DivyamSaini05/Project-Aeros/AEROS_Electronics_Schematic (1).pdf

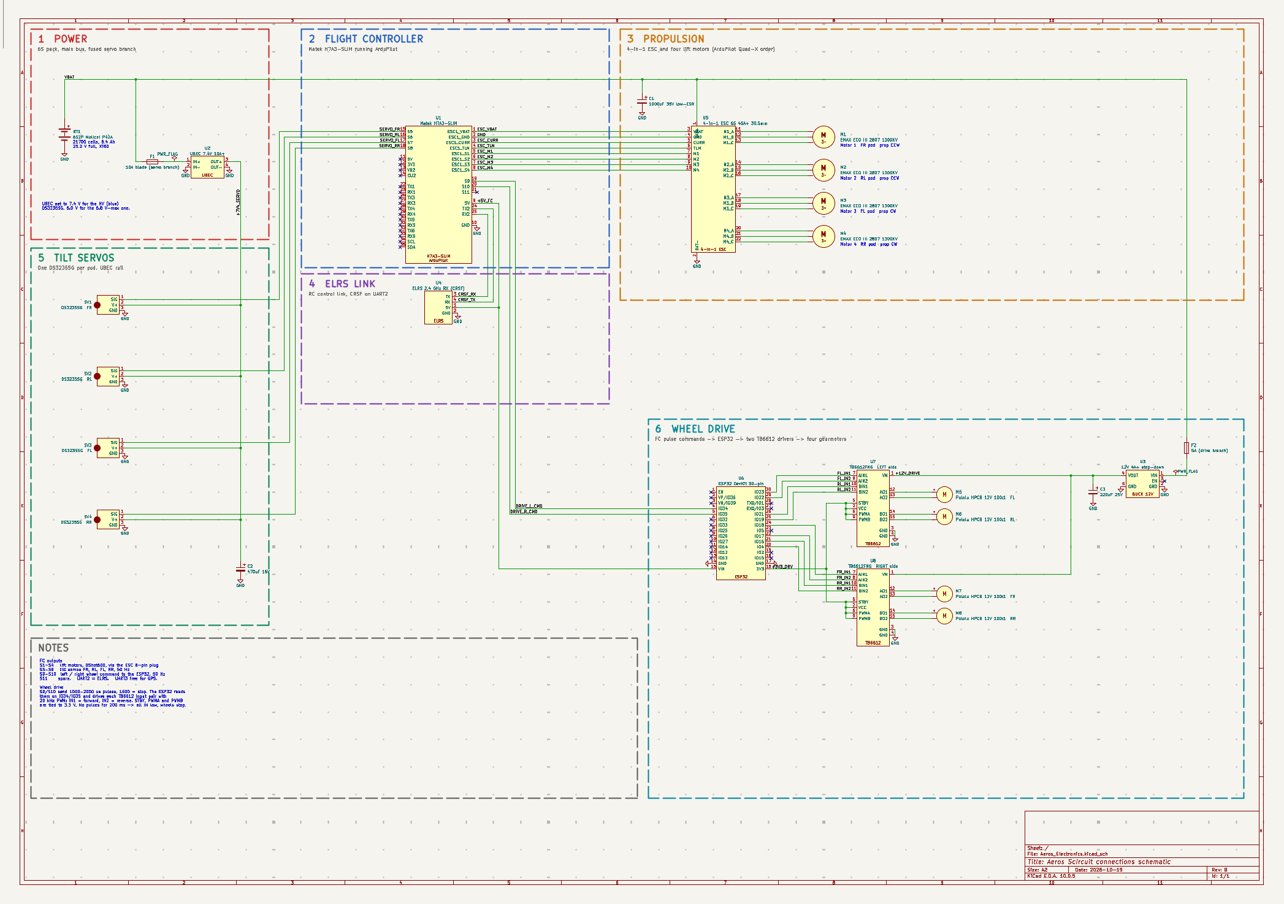
[picture p10: page 1]
