DivyamSaini05/Project-Aeros/AEROS_7in_BOM1_div.xlsx

# | Subsystem | Component | Spec / Part | Qty | Unit Price (USD) | Line Total (USD)
Flight Control & Propulsion
1 | Flight Control & Propulsion | Flight controller | Matek H7A3-SLIM, ArduPilot, 11 PWM out, CAN | 1 | $79.00 | $79.00 | Product page (https://www.nextfpv.com/products/matek-flight-controller-h7a3-slim)
2 | Flight Control & Propulsion | 4-in-1 ESC | SpeedyBee 55A 3-6S OX32 (AM32-based), 30.5x30.5 | 1 | $79.99 | $79.99 | Product page (https://www.getfpv.com/speedybee-55a-3-6s-ox32-4-in-1-esc-30-5x30-5.html)
3 | Flight Control & Propulsion | Lift motors | EMAX ECO III (E3) 2807 1300KV, 6S, 7in props | 5 | $23.99 | $119.95 | Product page (pick 1300KV) (https://www.racedayquads.com/products/emax-e3-series-2807-motor-1300kv-1500kv-1700kv)
4 | Flight Control & Propulsion | Propellers | 7in tri-blade (HQProp 7x4x3 or Gemfan 7040), 2CW+2CCW per set | 5 | $6.00 | $30.00 | Product page (https://www.racedayquads.com/products/hq-durable-7x4x3-tri-blade-7-prop-4-pack)
6 | Flight Control & Propulsion | ELRS receiver | RadioMaster RP3 V2 2.4GHz diversity | 1 | $22.00 | $22.00 | Product page (https://www.buddyrc.com/collections/receiver/products/radiomaster-rp3-expresslrs-2-4ghz-nano-receiver)
7 | Flight Control & Propulsion | Transmitter | RadioMaster Pocket | 1 | $80.00 | $80.00 | https://motionrc.com/products/radiomaster-pocket-16-channel-elrs-transmitter-charcoal-hp0157-0054-m2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
Tilt & Ground Drive
8 | Tilt & Ground Drive | Tilt servos | DSServo DS3235SG 35 kg-cm, steel gear, waterproof | 5 | $28.00 | $140.00 | Amazon search (https://www.amazon.com/s?k=DSServo+DS3235SG+35kg+servo)
9 | Tilt & Ground Drive | Servo BEC | Matek UBEC DUO, 2 x 4A, 5-8V adjustable, 9-55V in | 2 | $16.00 | $32.00 | Product page (https://www.myfpvstore.com/9l3r)
10 | Tilt & Ground Drive | Drive gearmotors | Pololu micro metal gearmotor 250:1 HPCB 12V, extended shaft | 4 | $27.00 | $108.00 | Product page (https://www.pololu.com/product/3055)
12 | Tilt & Ground Drive | Drive controller | ESP32-DevKitC (Espressif) | 1 | $10.00 | $10.00 | Product page (https://www.digikey.com/en/products/detail/espressif-systems/ESP32-DEVKITC-32E/12091810)
13 | Tilt & Ground Drive | Motor drivers | Pololu TB6612FNG dual motor driver carrier | 2 | $6.00 | $12.00 | Product page (https://www.pololu.com/product/713)
14 | Tilt & Ground Drive | 12V regulator | Pololu D36V28F12 (or equivalent) step-down, 6S in to 12V | 1 | $18.00 | $18.00 | Product page (https://www.pololu.com/product/3786)
15 | Tilt & Ground Drive | Bearings | Flanged ball bearings (tilt axles + wheel hubs), 20 pack | 1 | $15.00 | $15.00 | Amazon search (match your CAD sizes) (https://www.amazon.com/s?k=flanged+ball+bearing+assortment)
Power
17 | Battery |  | 6S 21700 Li-ion 5000Mah battery pack | 2 | $100.00 | $200.00 | https://www.getfpv.com/lumenier-nav-5000mah-6s-21700-lithium-ion-battery-xt60.html?afid=aVlOV0hBdmd6THc9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
19 | Power | Wiring & connectors | XT60/XT30, 12/14/18/22 AWG silicone wire, JST-GH/SH leads, heat shrink | 1 | $40.00 | $40.00 | Amazon search (https://www.amazon.com/s?k=XT60+connectors+silicone+wire+kit)
20 | Power | Smoke stopper | XT60 smoke stopper for first power-up | 1 | $15.00 | $15.00 | GetFPV search (https://www.getfpv.com/catalogsearch/result/?q=smoke+stopper+xt60)
21 | Power | Charger | 6S balance charger with built-in AC (ToolkitRC M6AC class) | 1 | $65.00 | $65.00 | Product page (https://www.getfpv.com/toolkitrc-m6ac-300w-15a-1-6s-ac-charger-xt60.html)
22 | Power | Battery safety bag | LiPo/Li-ion fireproof bag | 1 | $15.00 | $15.00 | Amazon search (https://www.amazon.com/s?k=lipo+safe+bag)
3D Printing & Hardware
24 | 3D Printing & Hardware | CF filament | PLA-CF filament 1kg | 3 | $20.00 | $60.00 | https://www.amazon.com/Creality-Filament-Hyper-PLA-CF-Dimensional/dp/B0CP7SFQG9?sp_csd=d2lkZ2V0TmFtZT1zcF9hdGY
26 | 3D Printing & Hardware | Screw assortment | Stainless M2 / M2.5 / M3 hex, nylock nuts | 1 | $25.00 | $25.00 | Amazon search (https://www.amazon.com/s?k=M2+M2.5+M3+stainless+hex+socket+screw+assortment)
27 | 3D Printing & Hardware | Heat-set inserts | Brass M2.5 / M3 insert kit | 1 | $15.00 | $15.00 | Amazon search (https://www.amazon.com/s?k=brass+heat+set+inserts+M3+M2.5+kit)
28 | 3D Printing & Hardware | Consumables | Threadlocker, zip ties, battery straps, double-sided foam | 1 | $20.00 | $20.00 | Amazon search (https://www.amazon.com/s?k=blue+threadlocker+zip+ties+battery+strap)
 | Tools | Soldering Station | 100W Soldering iron, solder, flux | 1 | $60.00 | 60
 | Tools | Multimeter | Multimeter | 1 | 10 | $10.00
 | Toolls | Wire cutters | Wire stripper, cutters | 1 | $30.00 | $30.00
 | Tools | Wires | Variety pack | 1 | $30.00 | $30.00
 | Tools | Heat shrink tubes | Variety pack | 1 | $10.00 | $10.00
 |  |  |  |  | Parts subtotal | $1340.94
