DivyamSaini05/Project-Aeros/Aeros_Build-1_CFD.step

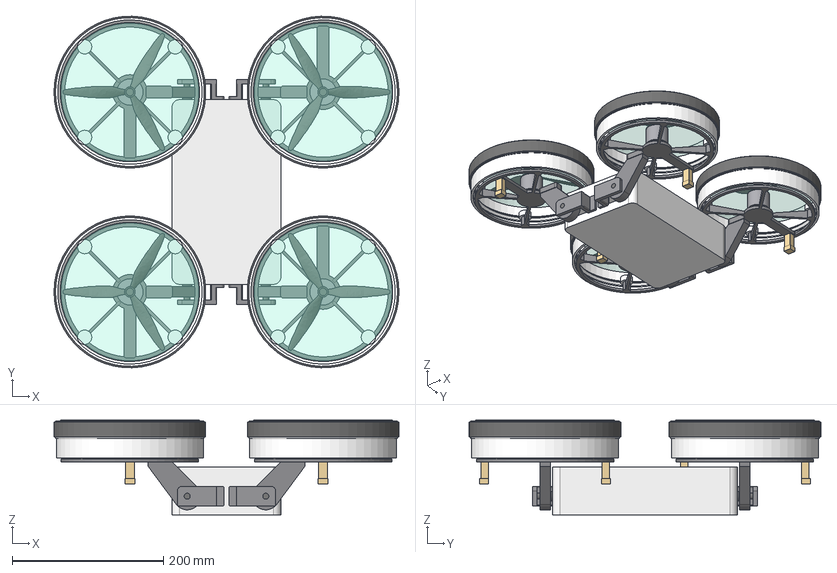
[picture p11: CAD file, 2026-10-21]
Aeros_Build-1_CFD.step
455.8 x 464.5 x 125.1 mm
Servo_FR
Yoke_FR
Servo_RL
Yoke_RL
Servo_FL
Yoke_FL
Servo_RR
Yoke_RR
Arm_FR
Horn_FR
Axle_FR
PodFrame_FR
Rollers_FR
RingDuct_FR
Tyre_FR
Motor_FR
Gearmotor_FR
Prop_FR_CCW
Arm_RL
Horn_RL
Axle_RL
PodFrame_RL
Rollers_RL
RingDuct_RL
Tyre_RL
Motor_RL
Gearmotor_RL
Prop_RL_CCW
Arm_FL
Horn_FL
Axle_FL
PodFrame_FL
Rollers_FL
RingDuct_FL
Tyre_FL
Motor_FL
Gearmotor_FL
Prop_FL_CW
Arm_RR
Horn_RR
Axle_RR
PodFrame_RR
Rollers_RR
RingDuct_RR
Tyre_RR
Motor_RR
Gearmotor_RR
Prop_RR_CW
RotorZone_FR
RotorZone_RL
RotorZone_FL
RotorZone_RR
