DivyamSaini05/Project-Aeros/Aeros_Build-1_PRINT.step

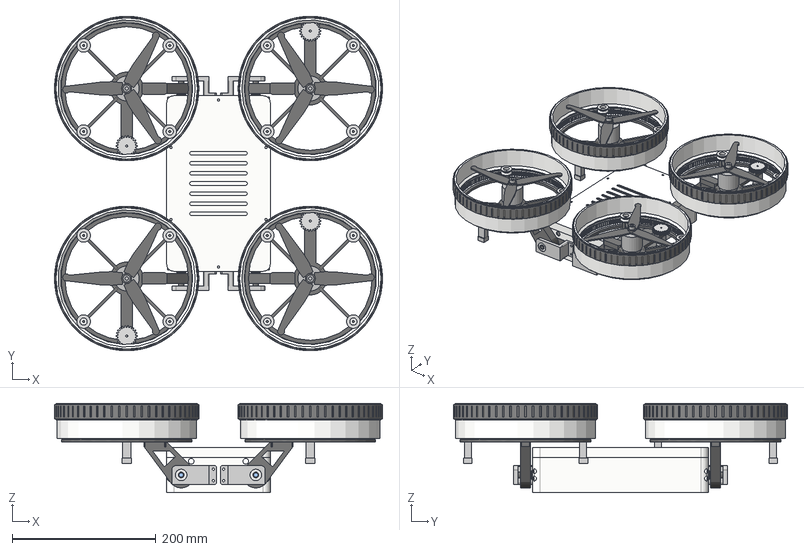
[picture p12: CAD file, 2026-10-21]
Aeros_Build-1_PRINT.step
455.8 x 464.6 x 124.1 mm
Ring wheel x 4
Tyre x 4
Pinion x 4
Motor stator 2807 x 4
Rotor CW x 2
Servo horn x 4
V roller x 16
Pod frame x 4
Axle tube x 4
Arm A x 2
Gearmotor x 4
Bearing 623 x 16
Rotor CCW x 2
Arm B x 2
Body lid
Body tub
Servo DS3235SG x 4
Bearing F688 x 4
Yoke A (1) x 2
Yoke B (1) x 2
