DivyamSaini05/Project-Aeros/(list of files, cad)

Other CAD files:
Aeros_Build-1_PRINT.f3d
