DivyamSaini05/Project-Aeros/Aeros_Electronics.kicad_sch

## KiCad design Aeros_Electronics.kicad_sch (2026-10-21)

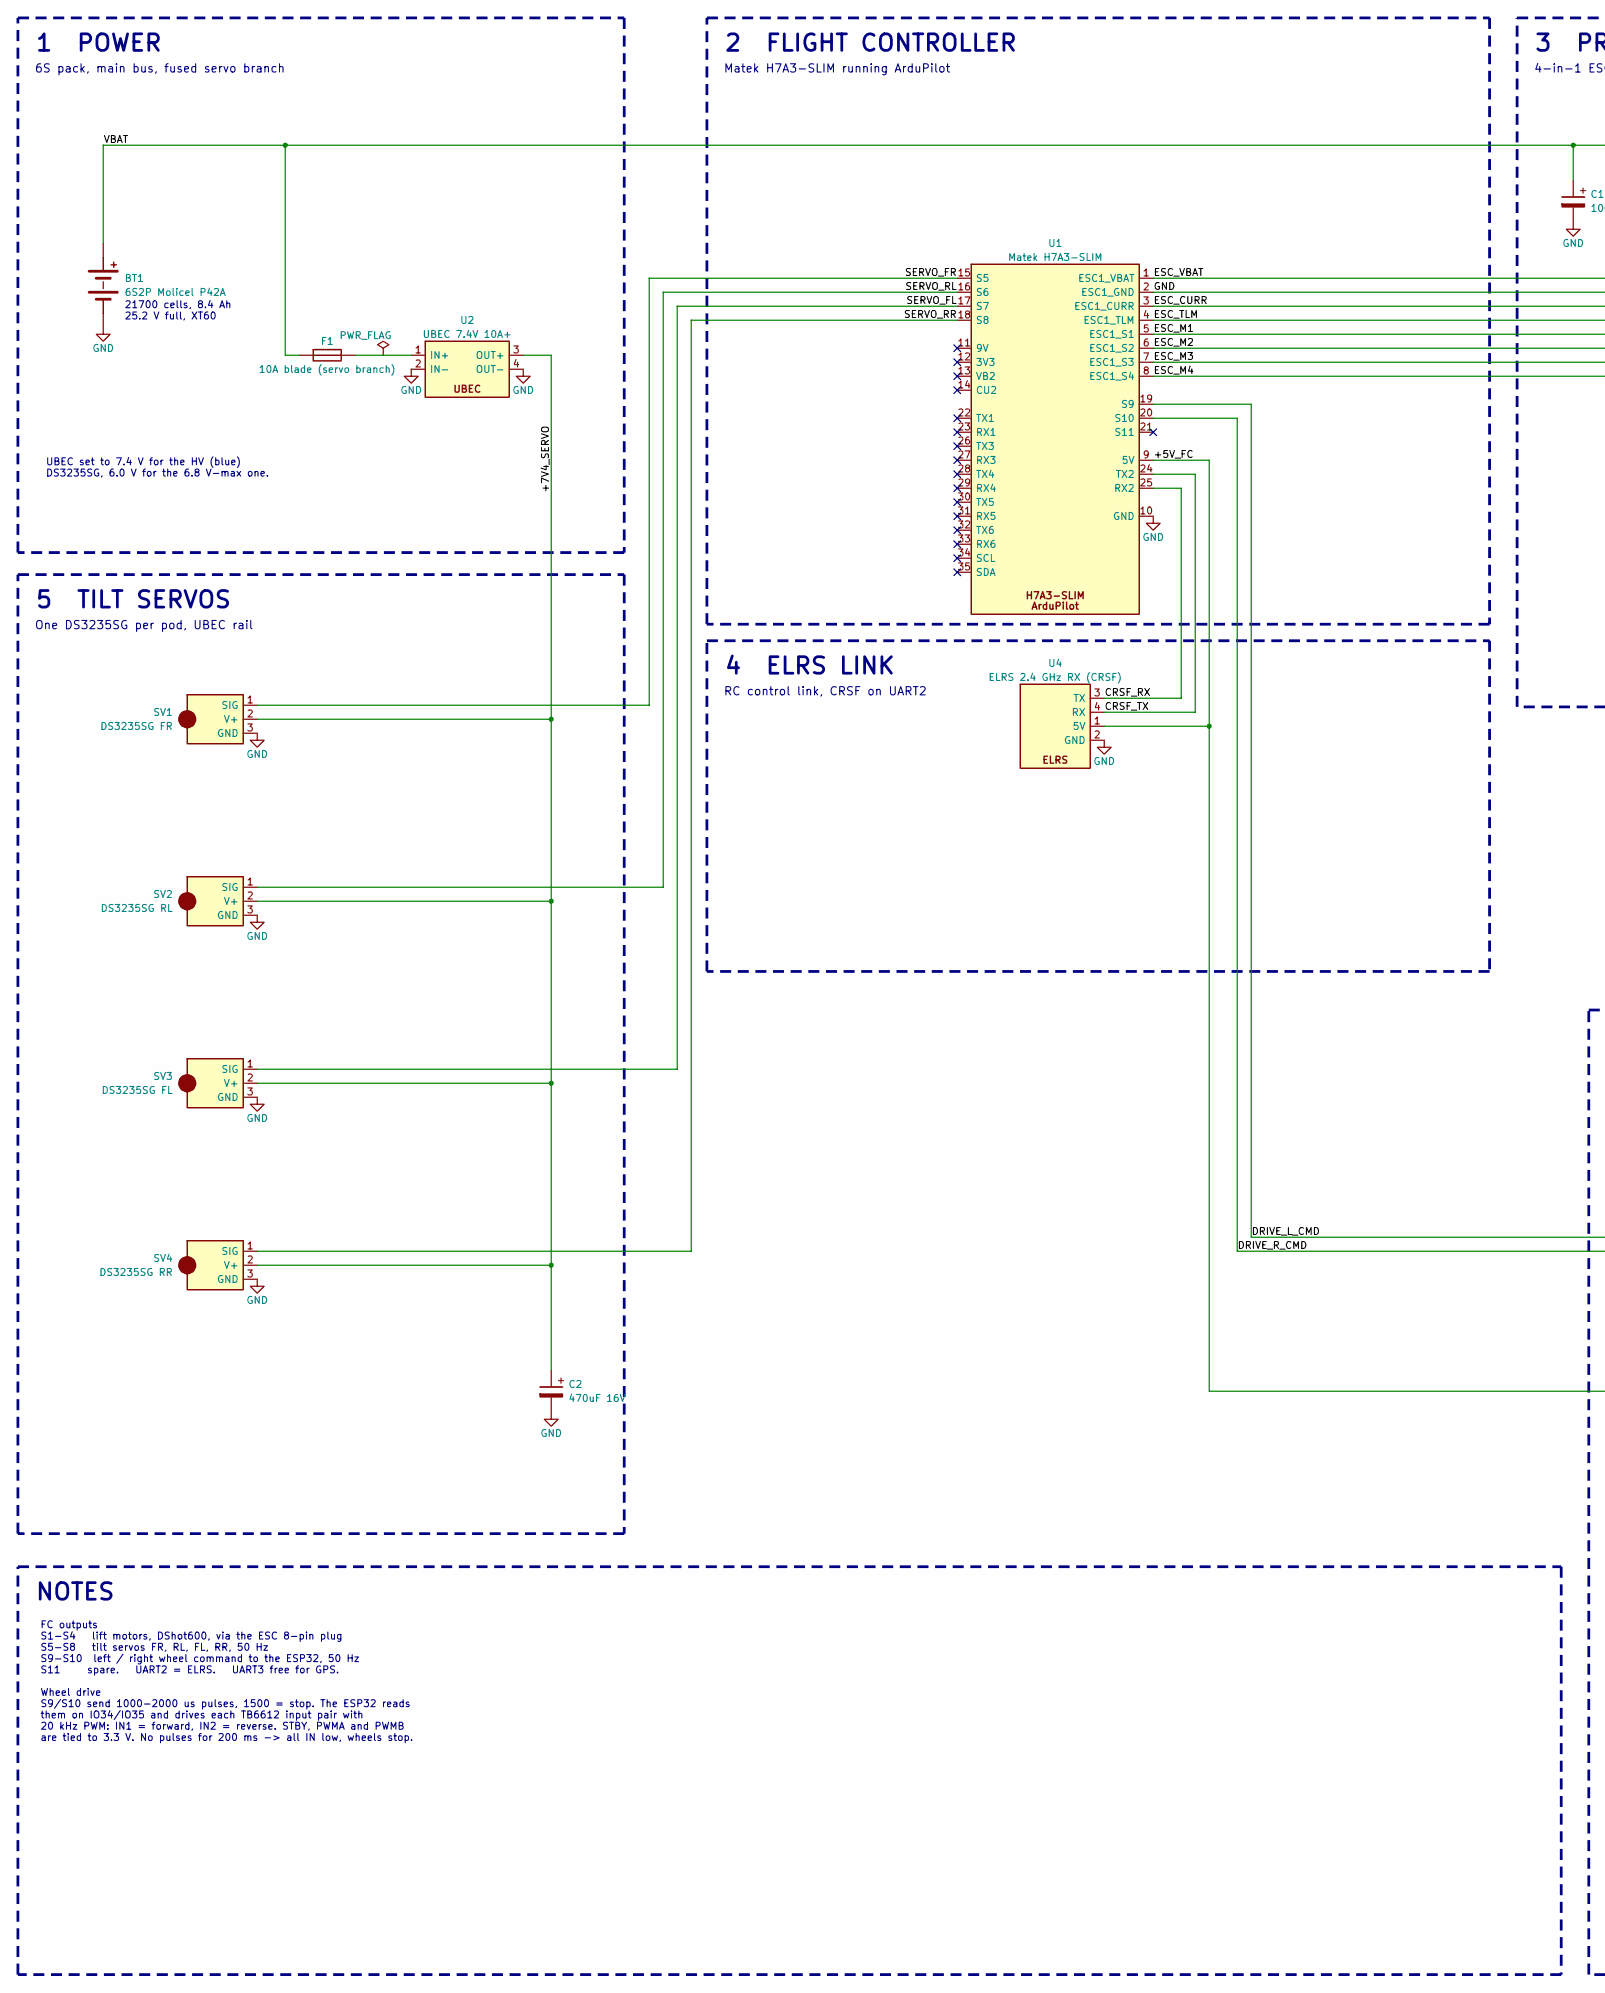
[picture p13: schematic Aeros_Electronics.kicad_sch, part in row 1, column 1]

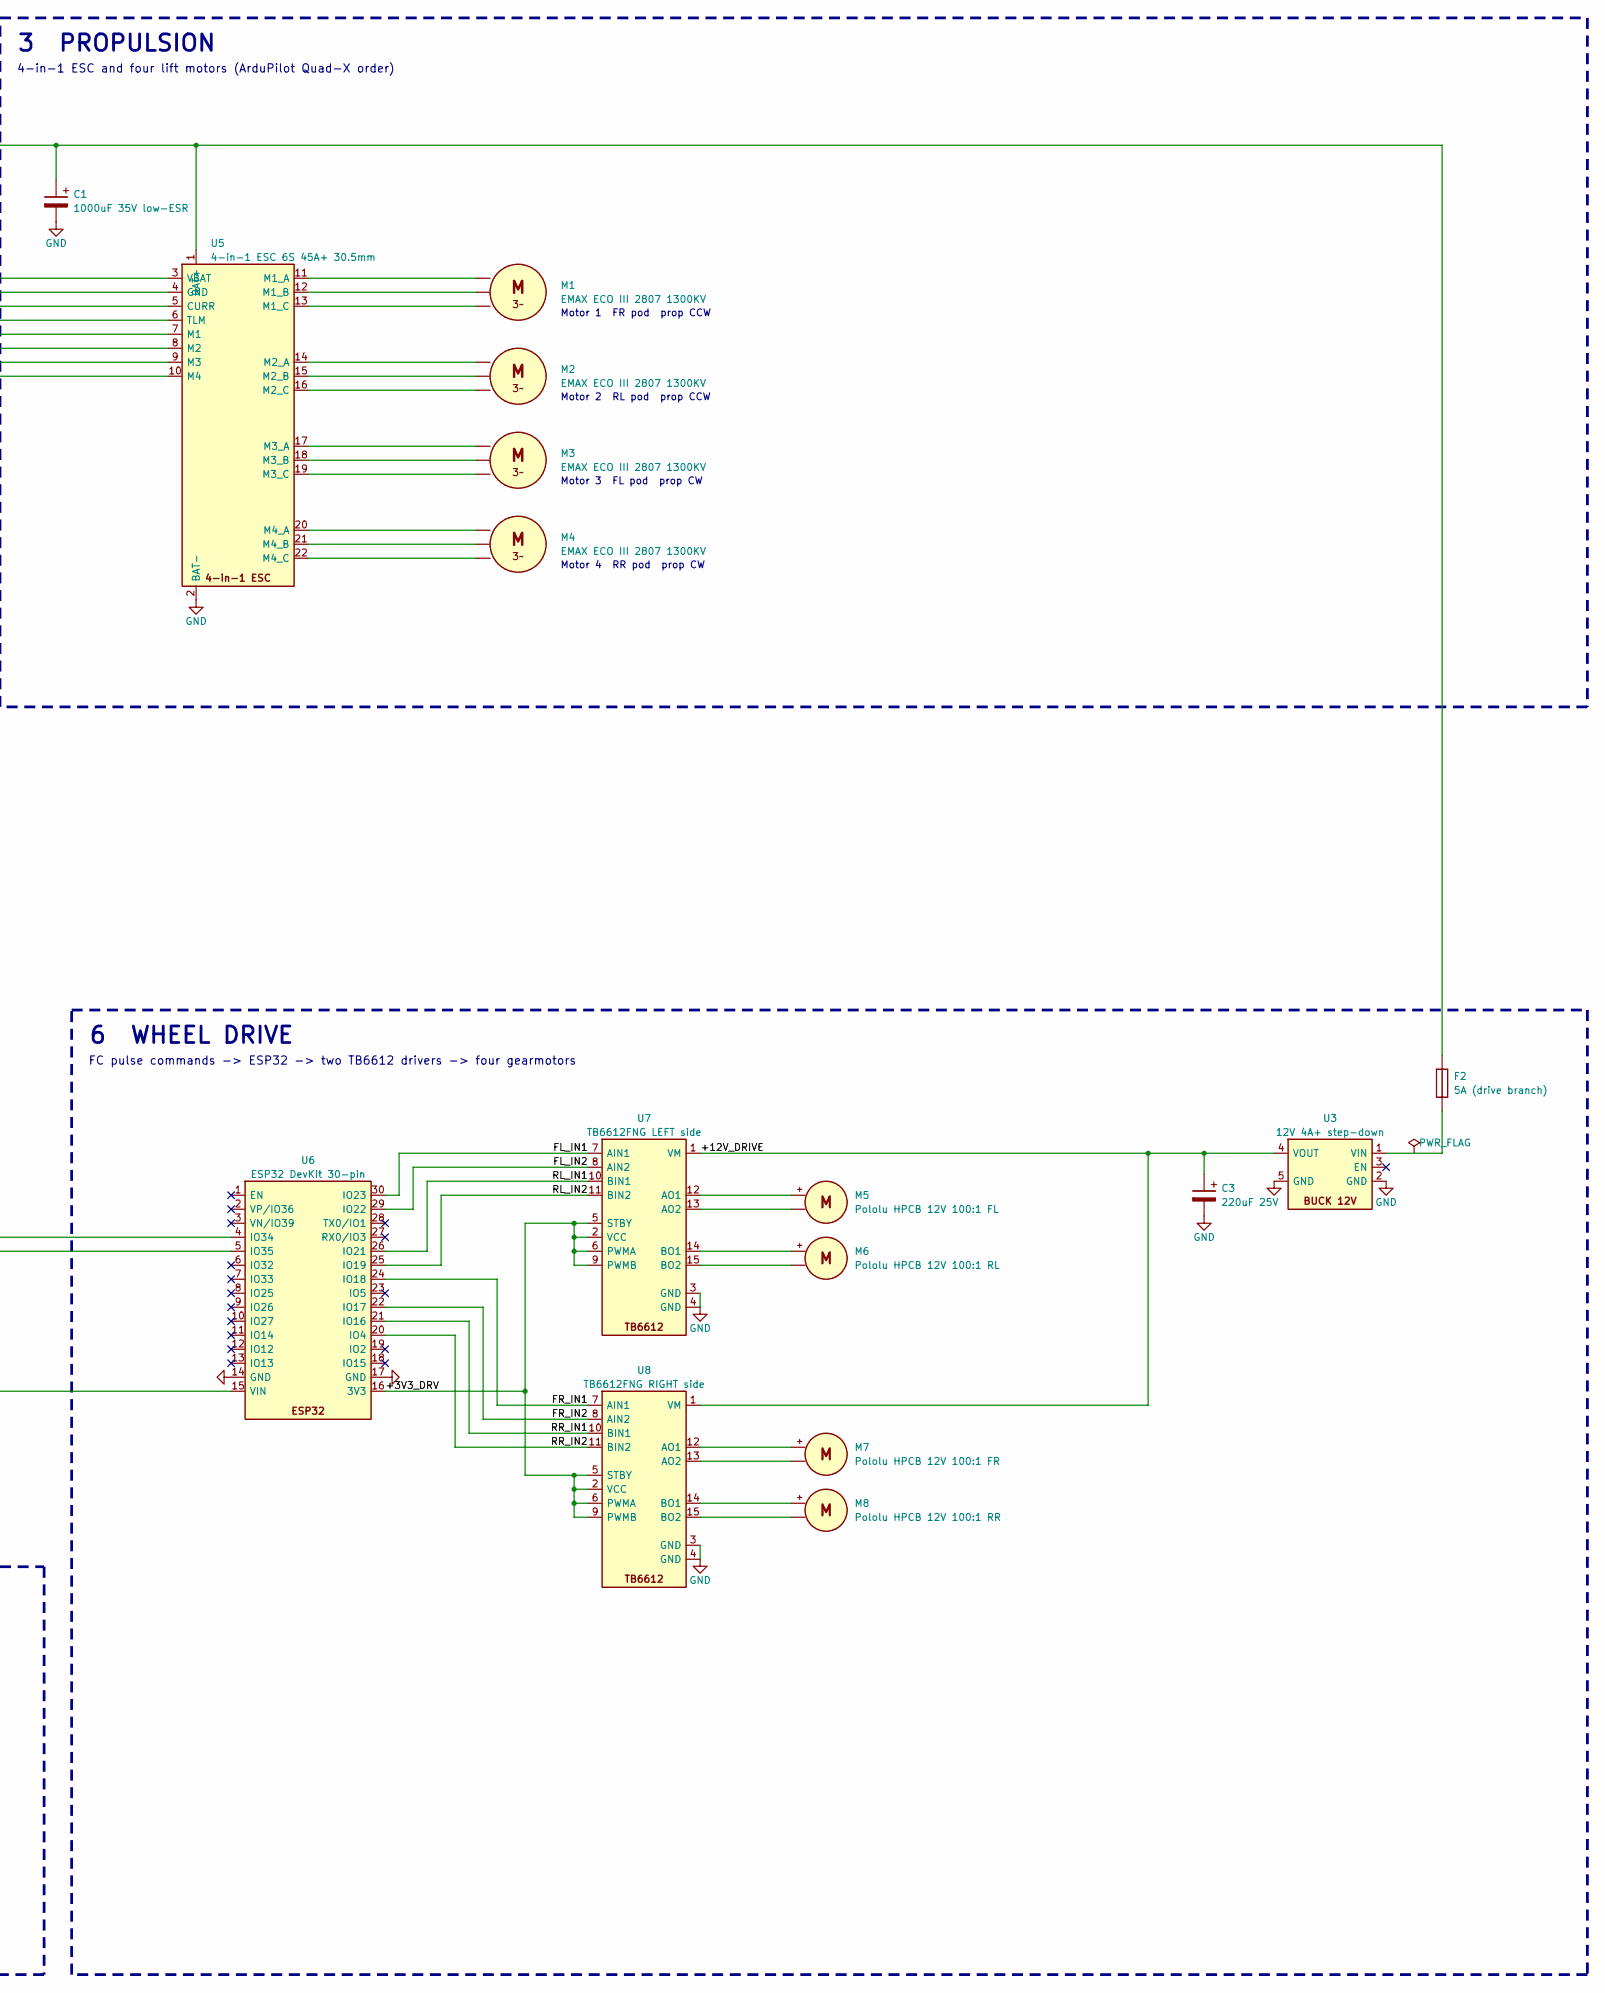
[picture p14: schematic Aeros_Electronics.kicad_sch, part in row 1, column 2]

Parts:
BT1: 6S2P Molicel P42A
C1: 1000uF 35V low-ESR
C2: 470uF 16V
C3: 220uF 25V
F1: 10A blade (servo branch)
F2: 5A (drive branch)
M1, M2, M3, M4: EMAX ECO III 2807 1300KV
M5: Pololu HPCB 12V 100:1 FL
M6: Pololu HPCB 12V 100:1 RL
M7: Pololu HPCB 12V 100:1 FR
M8: Pololu HPCB 12V 100:1 RR
SV1: DS3235SG FR
SV2: DS3235SG RL
SV3: DS3235SG FL
SV4: DS3235SG RR
U1: Matek H7A3-SLIM
U2: UBEC 7.4V 10A+
U3: 12V 4A+ step-down
U4: ELRS 2.4 GHz RX (CRSF)
U5: 4-in-1 ESC 6S 45A+ 30.5mm
U6: ESP32 DevKit 30-pin
U7: TB6612FNG LEFT side
U8: TB6612FNG RIGHT side

Connections:
+3V3_DRV: U6.16 (3V3), U7.2 (VCC), U7.5 (STBY), U7.6 (PWMA), U7.9 (PWMB), U8.2 (VCC), U8.5 (STBY), U8.6 (PWMA), U8.9 (PWMB)
+5V_FC: U1.9 (5V), U4.1 (5V), U6.15 (VIN)
+7V4_SERVO: C2.1 (+), SV1.2 (V+), SV2.2 (V+), SV3.2 (V+), SV4.2 (V+), U2.3 (OUT+)
+12V_DRIVE: C3.1 (+), U3.4 (VOUT), U7.1 (VM), U8.1 (VM)
CRSF_RX: U1.25 (RX2), U4.3 (TX)
CRSF_TX: U1.24 (TX2), U4.4 (RX)
DRIVE_L_CMD: U1.19 (S9), U6.4 (IO34)
DRIVE_R_CMD: U1.20 (S10), U6.5 (IO35)
ESC_CURR: U1.3 (ESC1_CURR), U5.5 (CURR)
ESC_M1: U1.5 (ESC1_S1), U5.7 (M1)
ESC_M2: U1.6 (ESC1_S2), U5.8 (M2)
ESC_M3: U1.7 (ESC1_S3), U5.9 (M3)
ESC_M4: U1.8 (ESC1_S4), U5.10 (M4)
ESC_TLM: U1.4 (ESC1_TLM), U5.6 (TLM)
ESC_VBAT: U1.1 (ESC1_VBAT), U5.3 (VBAT)
FL_IN1: U6.30 (IO23), U7.7 (AIN1)
FL_IN2: U6.29 (IO22), U7.8 (AIN2)
FR_IN1: U6.24 (IO18), U8.7 (AIN1)
FR_IN2: U6.22 (IO17), U8.8 (AIN2)
GND: BT1.2 (-), C1.2 (-), C2.2 (-), C3.2 (-), SV1.3 (GND), SV2.3 (GND), SV3.3 (GND), SV4.3 (GND), U1.2 (ESC1_GND), U1.10 (GND), U2.2 (IN-), U2.4 (OUT-), U3.2 (GND), U3.5 (GND), U4.2 (GND), U5.2 (BAT-), U5.4 (GND), U6.14 (GND), U6.17 (GND), U7.3 (GND), U7.4 (GND), U8.3 (GND), U8.4 (GND)
unnamed: F1.2, U2.1 (IN+)
unnamed: F2.2, U3.1 (VIN)
unnamed: M1.1 (A), U5.11 (M1_A)
unnamed: M1.2 (B), U5.12 (M1_B)
unnamed: M1.3 (C), U5.13 (M1_C)
unnamed: M2.1 (A), U5.14 (M2_A)
unnamed: M2.2 (B), U5.15 (M2_B)
unnamed: M2.3 (C), U5.16 (M2_C)
unnamed: M3.1 (A), U5.17 (M3_A)
unnamed: M3.2 (B), U5.18 (M3_B)
unnamed: M3.3 (C), U5.19 (M3_C)
unnamed: M4.1 (A), U5.20 (M4_A)
unnamed: M4.2 (B), U5.21 (M4_B)
unnamed: M4.3 (C), U5.22 (M4_C)
unnamed: M5.1 (+), U7.12 (AO1)
unnamed: M5.2 (-), U7.13 (AO2)
unnamed: M6.1 (+), U7.14 (BO1)
unnamed: M6.2 (-), U7.15 (BO2)
unnamed: M7.1 (+), U8.12 (AO1)
unnamed: M7.2 (-), U8.13 (AO2)
unnamed: M8.1 (+), U8.14 (BO1)
unnamed: M8.2 (-), U8.15 (BO2)
RL_IN1: U6.26 (IO21), U7.10 (BIN1)
RL_IN2: U6.25 (IO19), U7.11 (BIN2)
RR_IN1: U6.21 (IO16), U8.10 (BIN1)
RR_IN2: U6.20 (IO4), U8.11 (BIN2)
SERVO_FL: SV3.1 (SIG), U1.17 (S7)
SERVO_FR: SV1.1 (SIG), U1.15 (S5)
SERVO_RL: SV2.1 (SIG), U1.16 (S6)
SERVO_RR: SV4.1 (SIG), U1.18 (S8)
VBAT: BT1.1 (+), C1.1 (+), F1.1, F2.1, U5.1 (BAT+)

Notes on the sheet:
Motor 3 FL pod prop CW
Motor 1 FR pod prop CCW
1 POWER
Motor 2 RL pod prop CCW
5 TILT SERVOS
4-in-1 ESC and four lift motors (ArduPilot Quad-X order)
6 WHEEL DRIVE
FC pulse commands -> ESP32 -> two TB6612 drivers -> four gearmotors
One DS3235SG per pod, UBEC rail
6S pack, main bus, fused servo branch
FC outputs S1-S4 lift motors, DShot600, via the ESC 8-pin plug S5-S8 tilt servos FR, RL, FL, RR, 50 Hz S9-S10 left / right wheel command to the ESP32, 50 Hz S11 spare. UART2 = ELRS. UART3 free for GPS. Wheel drive S9/S10 send 1000-2000 us pulses, 1500 = stop. The ESP32 reads them on IO34/IO35 and d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
3 PROPULSION
RC control link, CRSF on UART2
4 ELRS LINK
2 FLIGHT CONTROLLER
Motor 4 RR pod prop CW
NOTES
UBEC set to 7.4 V for the HV (blue) DS3235SG, 6.0 V for the 6.8 V-max one.
21700 cells, 8.4 Ah 25.2 V full, XT60
Matek H7A3-SLIM running ArduPilot
